Dmatt547/Automatic-Dog-Feeder-Final/Weight_and_temp_sensor/secrets.h

// Use this file to store all of the private credentials 
// and connection details

#define SECRET_SSID "Dan"		// replace MySSID with your WiFi network name
#define SECRET_PASS "dan1234567890"	// replace MyPassword with your WiFi password
